Narcosia/stargate-agent-monitor/docs/img/gate-front-ams.png

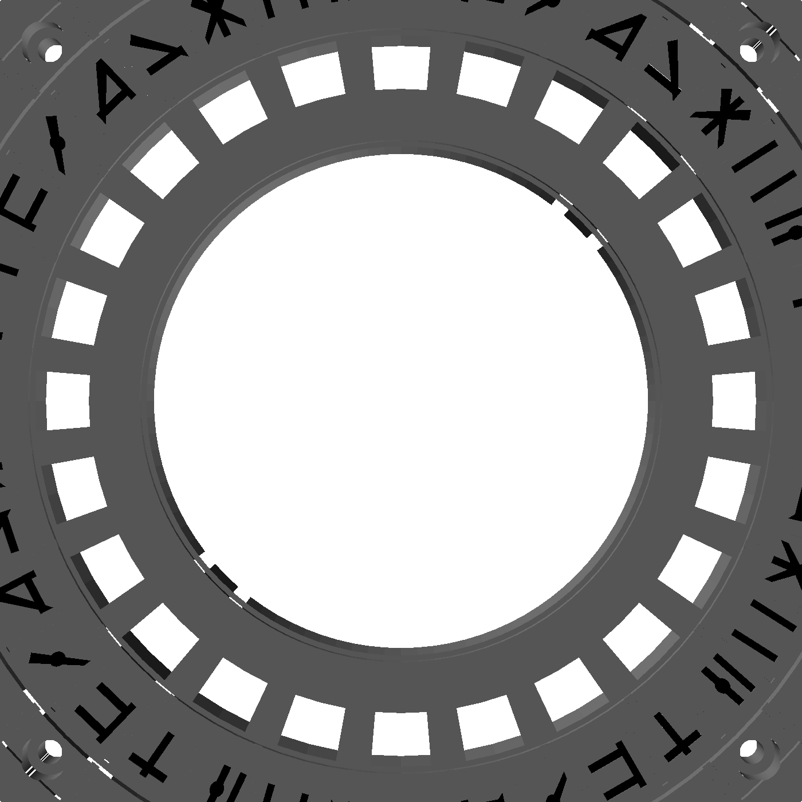
docs/img/gate-front-ams.png
