Narcosia/stargate-agent-monitor/docs/img/gate-stack-edge.png

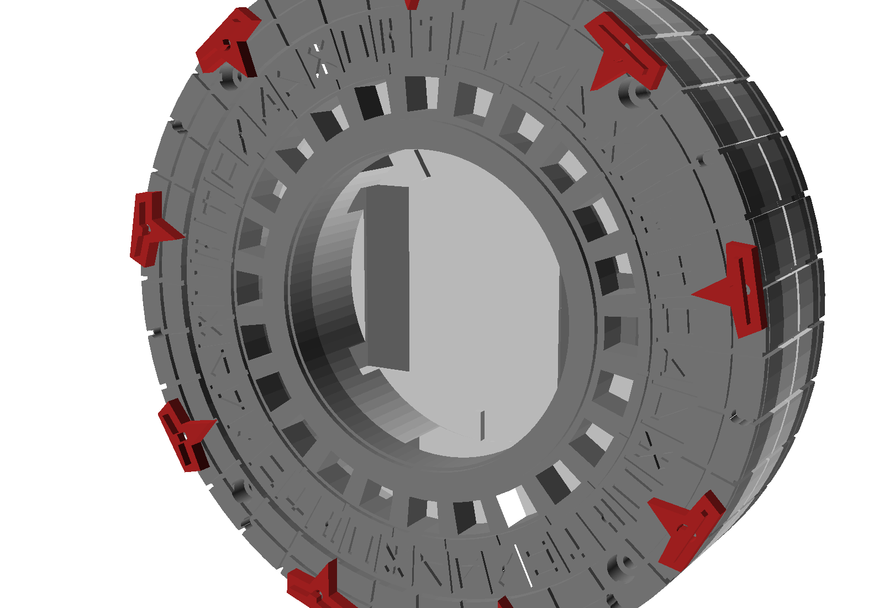
docs/img/gate-stack-edge.png
