Narcosia/stargate-agent-monitor/docs/img/inserts-base-under.png

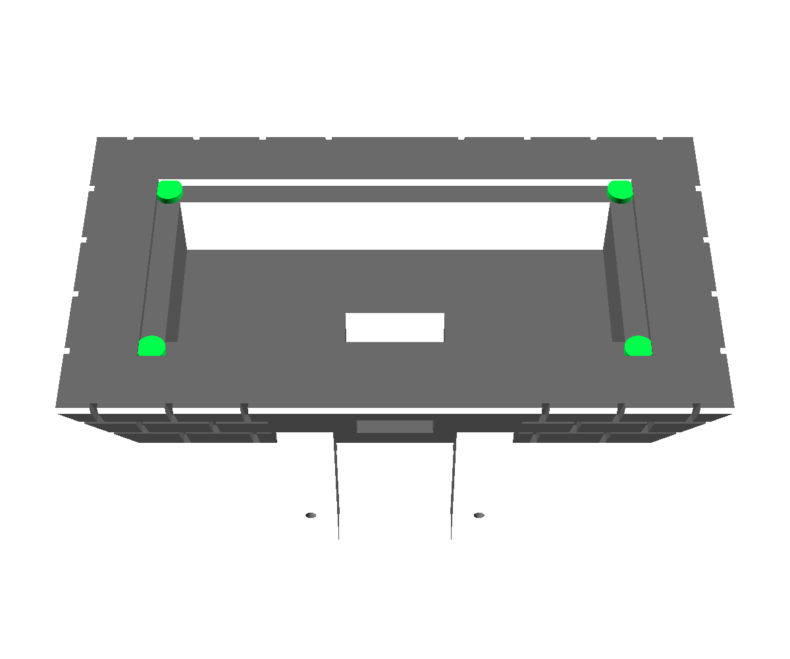
docs/img/inserts-base-under.png
