Narcosia/stargate-agent-monitor/docs/img/inserts-front-face.png

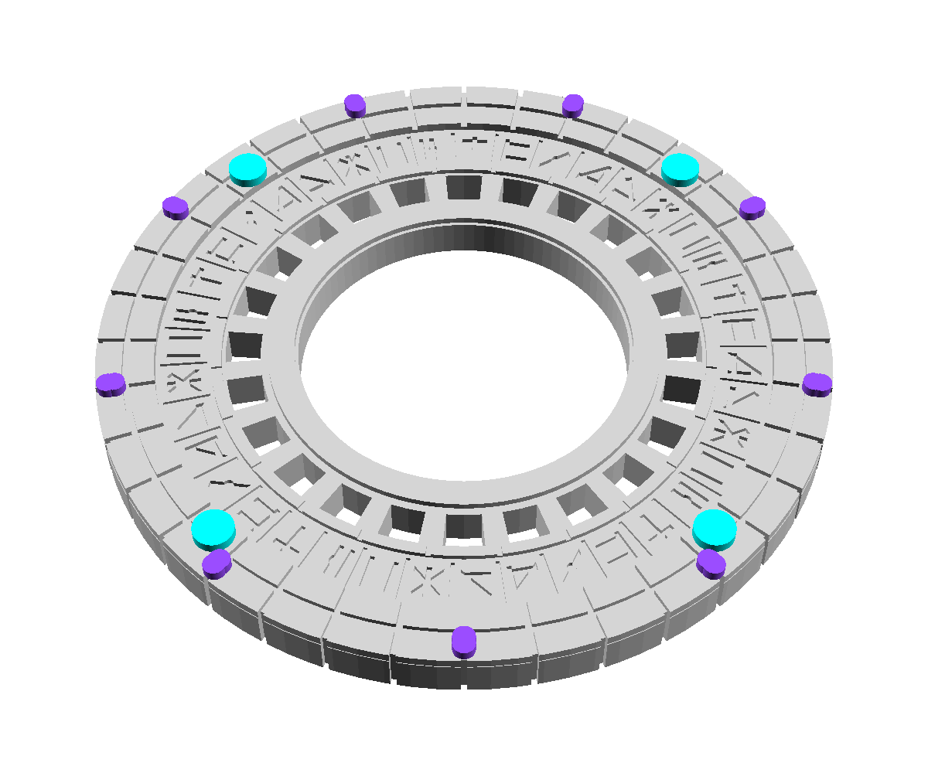
docs/img/inserts-front-face.png
