Narcosia/stargate-agent-monitor/docs/img/inserts-rear-back.png

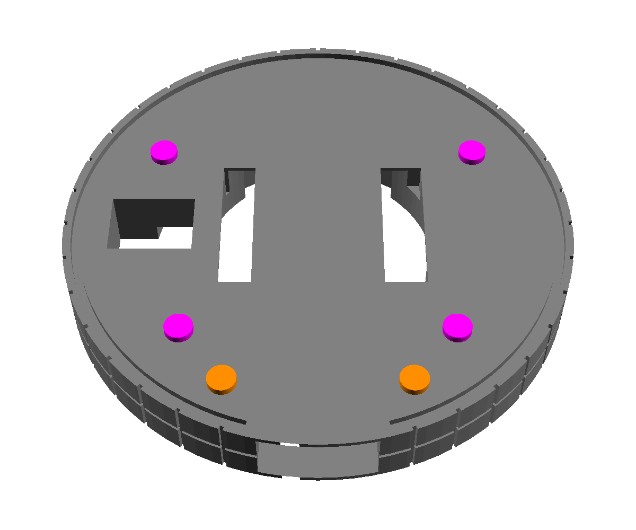
docs/img/inserts-rear-back.png
