Narcosia/stargate-agent-monitor/docs/img/inserts-rear-front.png

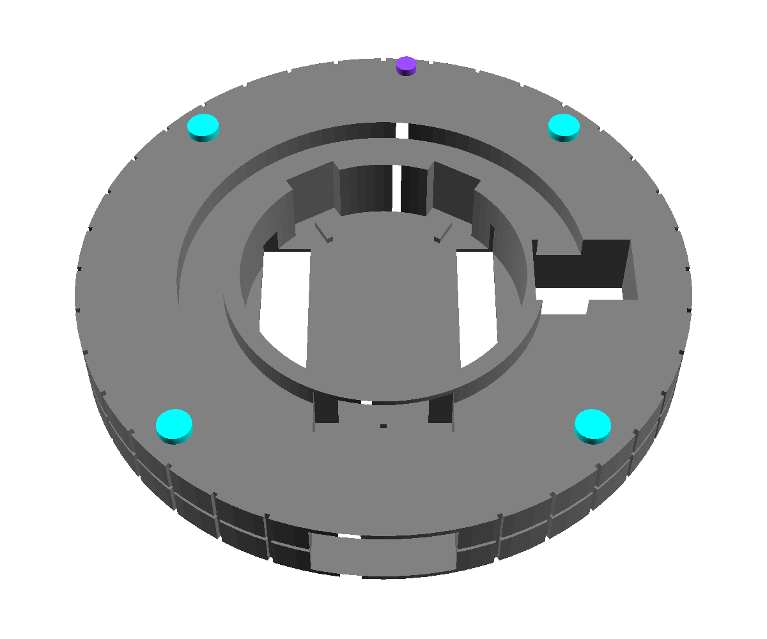
docs/img/inserts-rear-front.png
