Narcosia/stargate-agent-monitor/docs/img/rear-cover-bosses.png

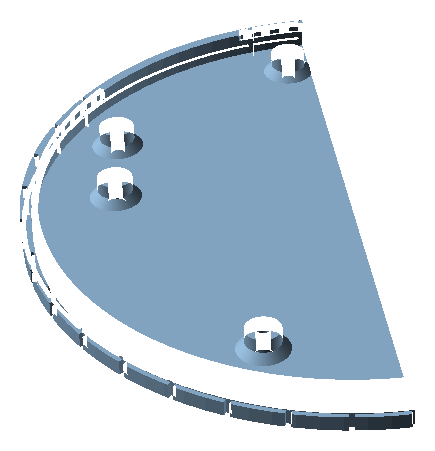
docs/img/rear-cover-bosses.png
