Narcosia/stargate-agent-monitor/(list of files, cad)

Other CAD files:
enclosure/diffuser.scad
