Narcosia/stargate-agent-monitor/docs/img/assembly-exploded.png

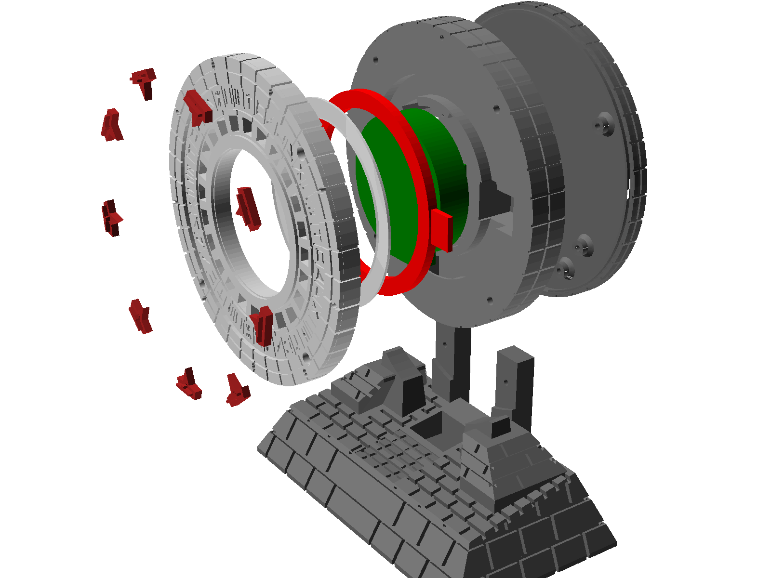
docs/img/assembly-exploded.png
