Narcosia/stargate-agent-monitor/docs/img/assembly-front.png

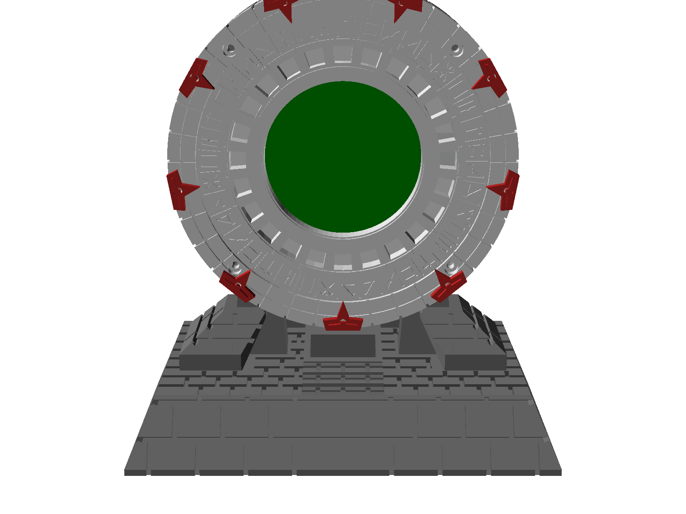
docs/img/assembly-front.png
