Narcosia/stargate-agent-monitor/docs/img/assembly-rear.png

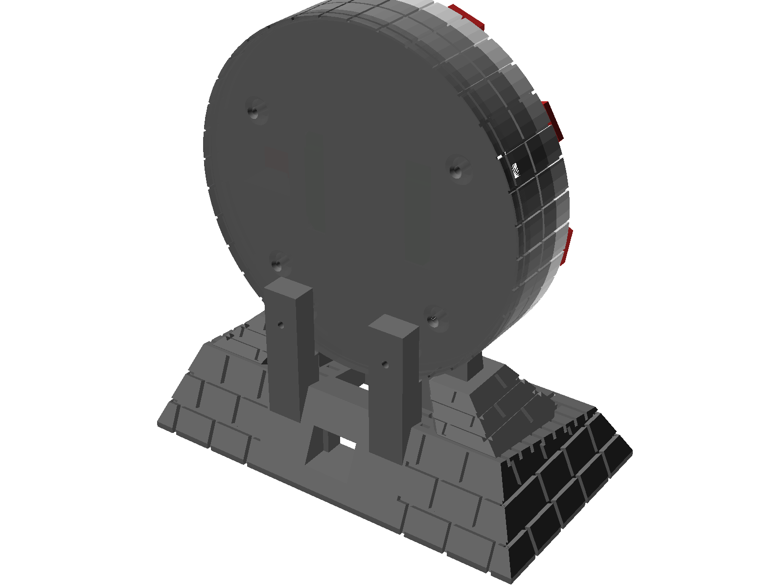
docs/img/assembly-rear.png
