Narcosia/stargate-agent-monitor/docs/img/assembly-threequarter.png

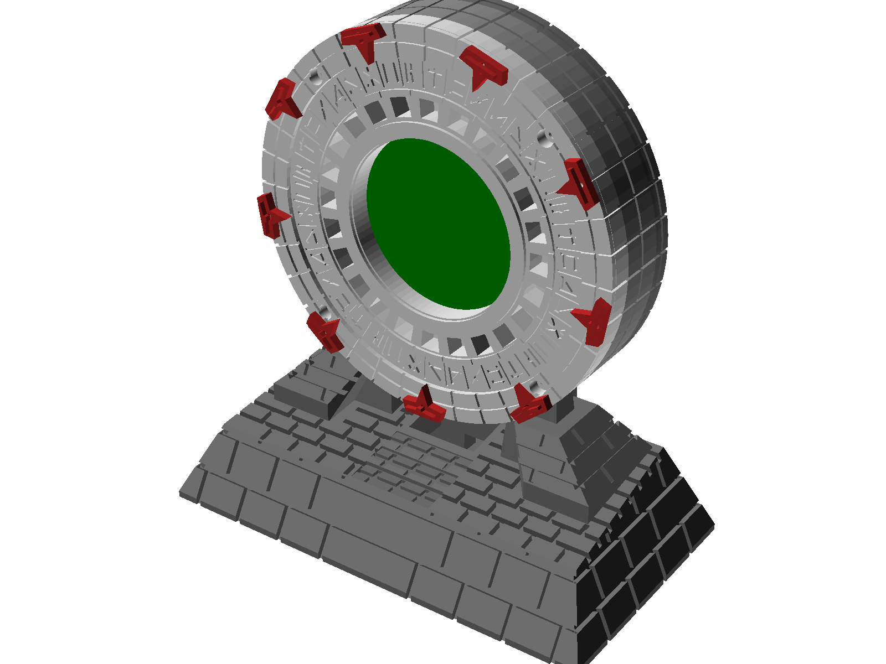
docs/img/assembly-threequarter.png
