Narcosia/stargate-agent-monitor/docs/img/build-cover-screws-1.jpg

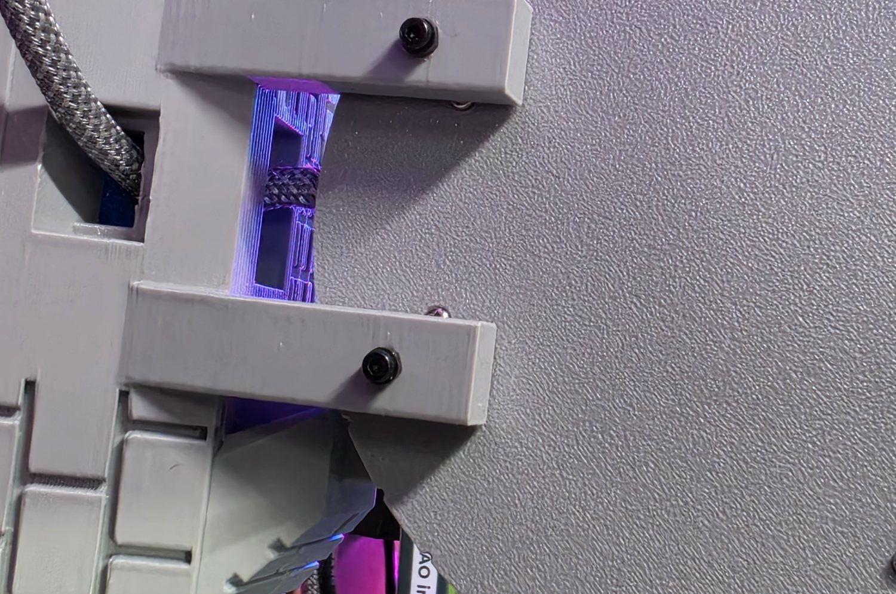
docs/img/build-cover-screws-1.jpg
