Narcosia/stargate-agent-monitor/docs/img/build-cover-screws-2.jpg

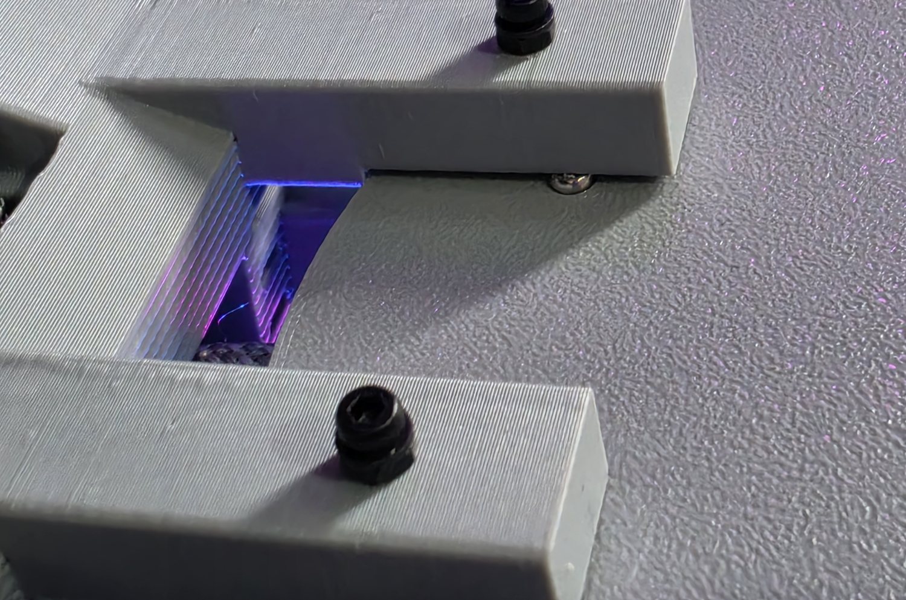
docs/img/build-cover-screws-2.jpg
