Narcosia/stargate-agent-monitor/docs/img/build-first-light.jpg

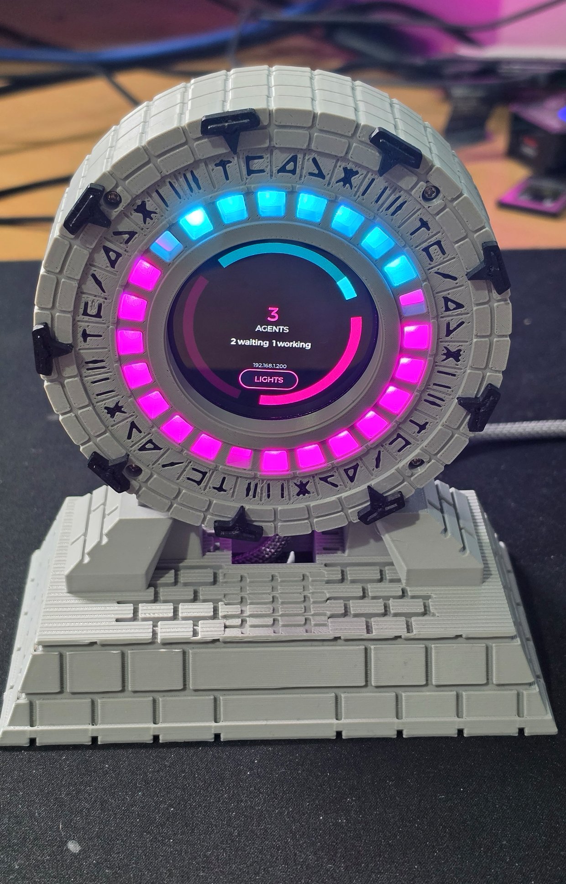
docs/img/build-first-light.jpg
