Narcosia/stargate-agent-monitor/docs/img/wiring-puck-rear.jpg

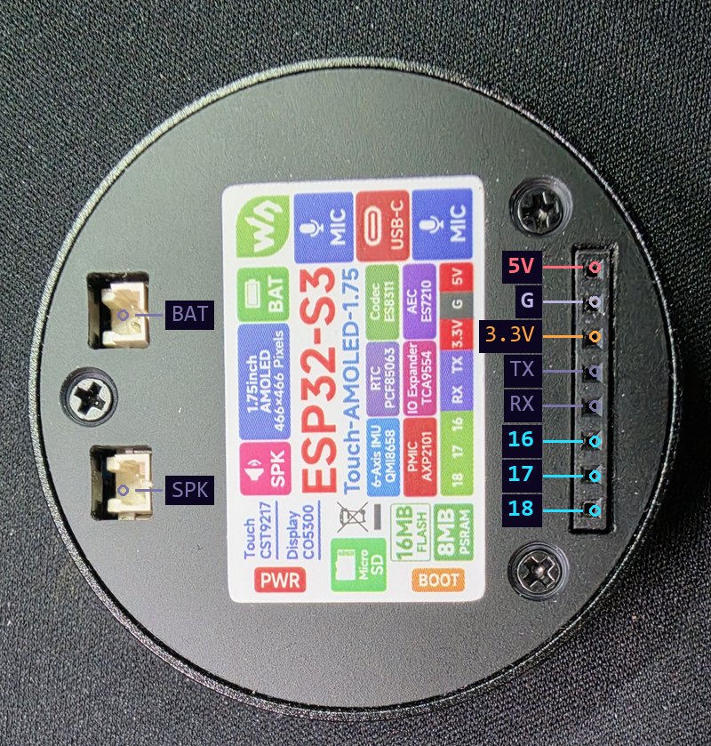
docs/img/wiring-puck-rear.jpg
