Narcosia/stargate-agent-monitor/docs/img/wiring-ring-pads.png

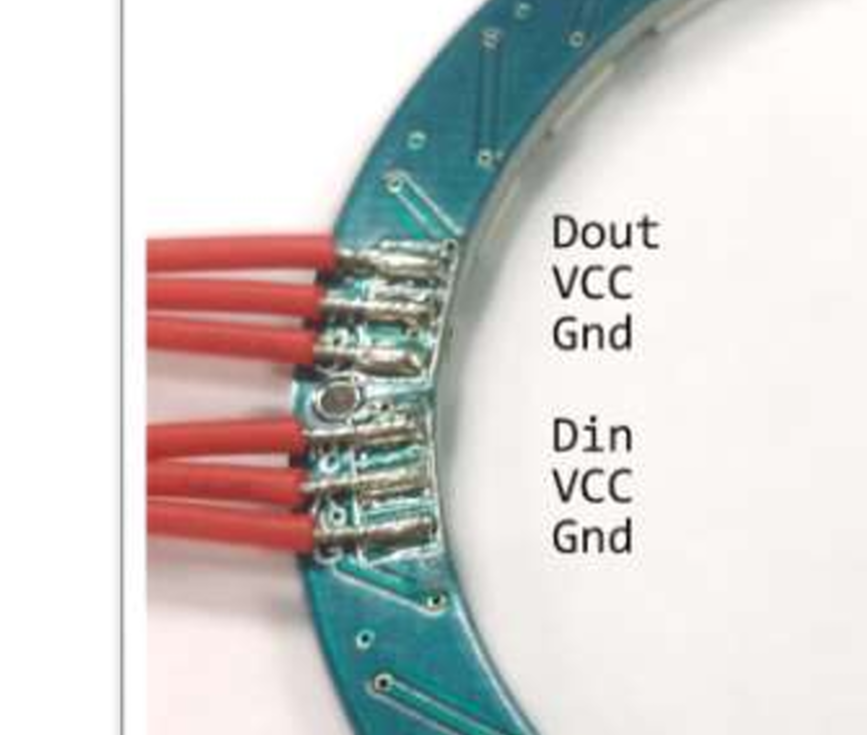
docs/img/wiring-ring-pads.png
