Narcosia/stargate-agent-monitor/(commit log)

2026-11-02 Stargate Agent Monitor: first public release
    A desk Stargate that shows live Claude Code session state: an ESP32-S3
    round AMOLED in the gate's centre and a 24-LED WS2812B ring behind the
    gate's windows, driven straight from Claude Code's HTTP hooks.
    - console/: Arduino/C++ firmware for the Waveshare ESP32-S3 puck
    - repo root: the original MicroPython ring-only firmware + hook installer
    - enclosure/: parametric OpenSCAD source for the Stargate and pedestal
    - docs/: build writeup (GitHub Pages) with wiring, print and assembly guide
    Printable files and the Bambu Studio print profile are on MakerWorld:
    https://makerworld.com/en/models/3533985
    Code is MIT; the enclosure design is CC BY-NC-SA 4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
    [assembly.scad, base_bottom.scad, base_main.scad, chevron.scad, config.scad, couponA.scad, couponB.scad, couponC.scad]
2026-11-02 docs: NZ buy links in the parts list (#1)
    Link the writeup BOM and the README parts list to the parts used for
    the build: the Waveshare puck (with protective case) and heat-set
    inserts on AliExpress; the WS2812B ring (XC4385), Keyestudio ESP32
    (XC3800), jumper leads (WC6024), 1N5822 Schottky (ZR1048) and 330 ohm
    0.5 W resistor (RR0560) at Jaycar NZ.
    Also corrects two BOM details: the rubber feet must fit the base's
    10 mm recesses, and the chevrons on the shown build are black.
